UCSD-Quadcopter-Class/quad-hardware-yq_10/quadcopter.brd

## EAGLE design quadcopter.brd (2017-05-15)

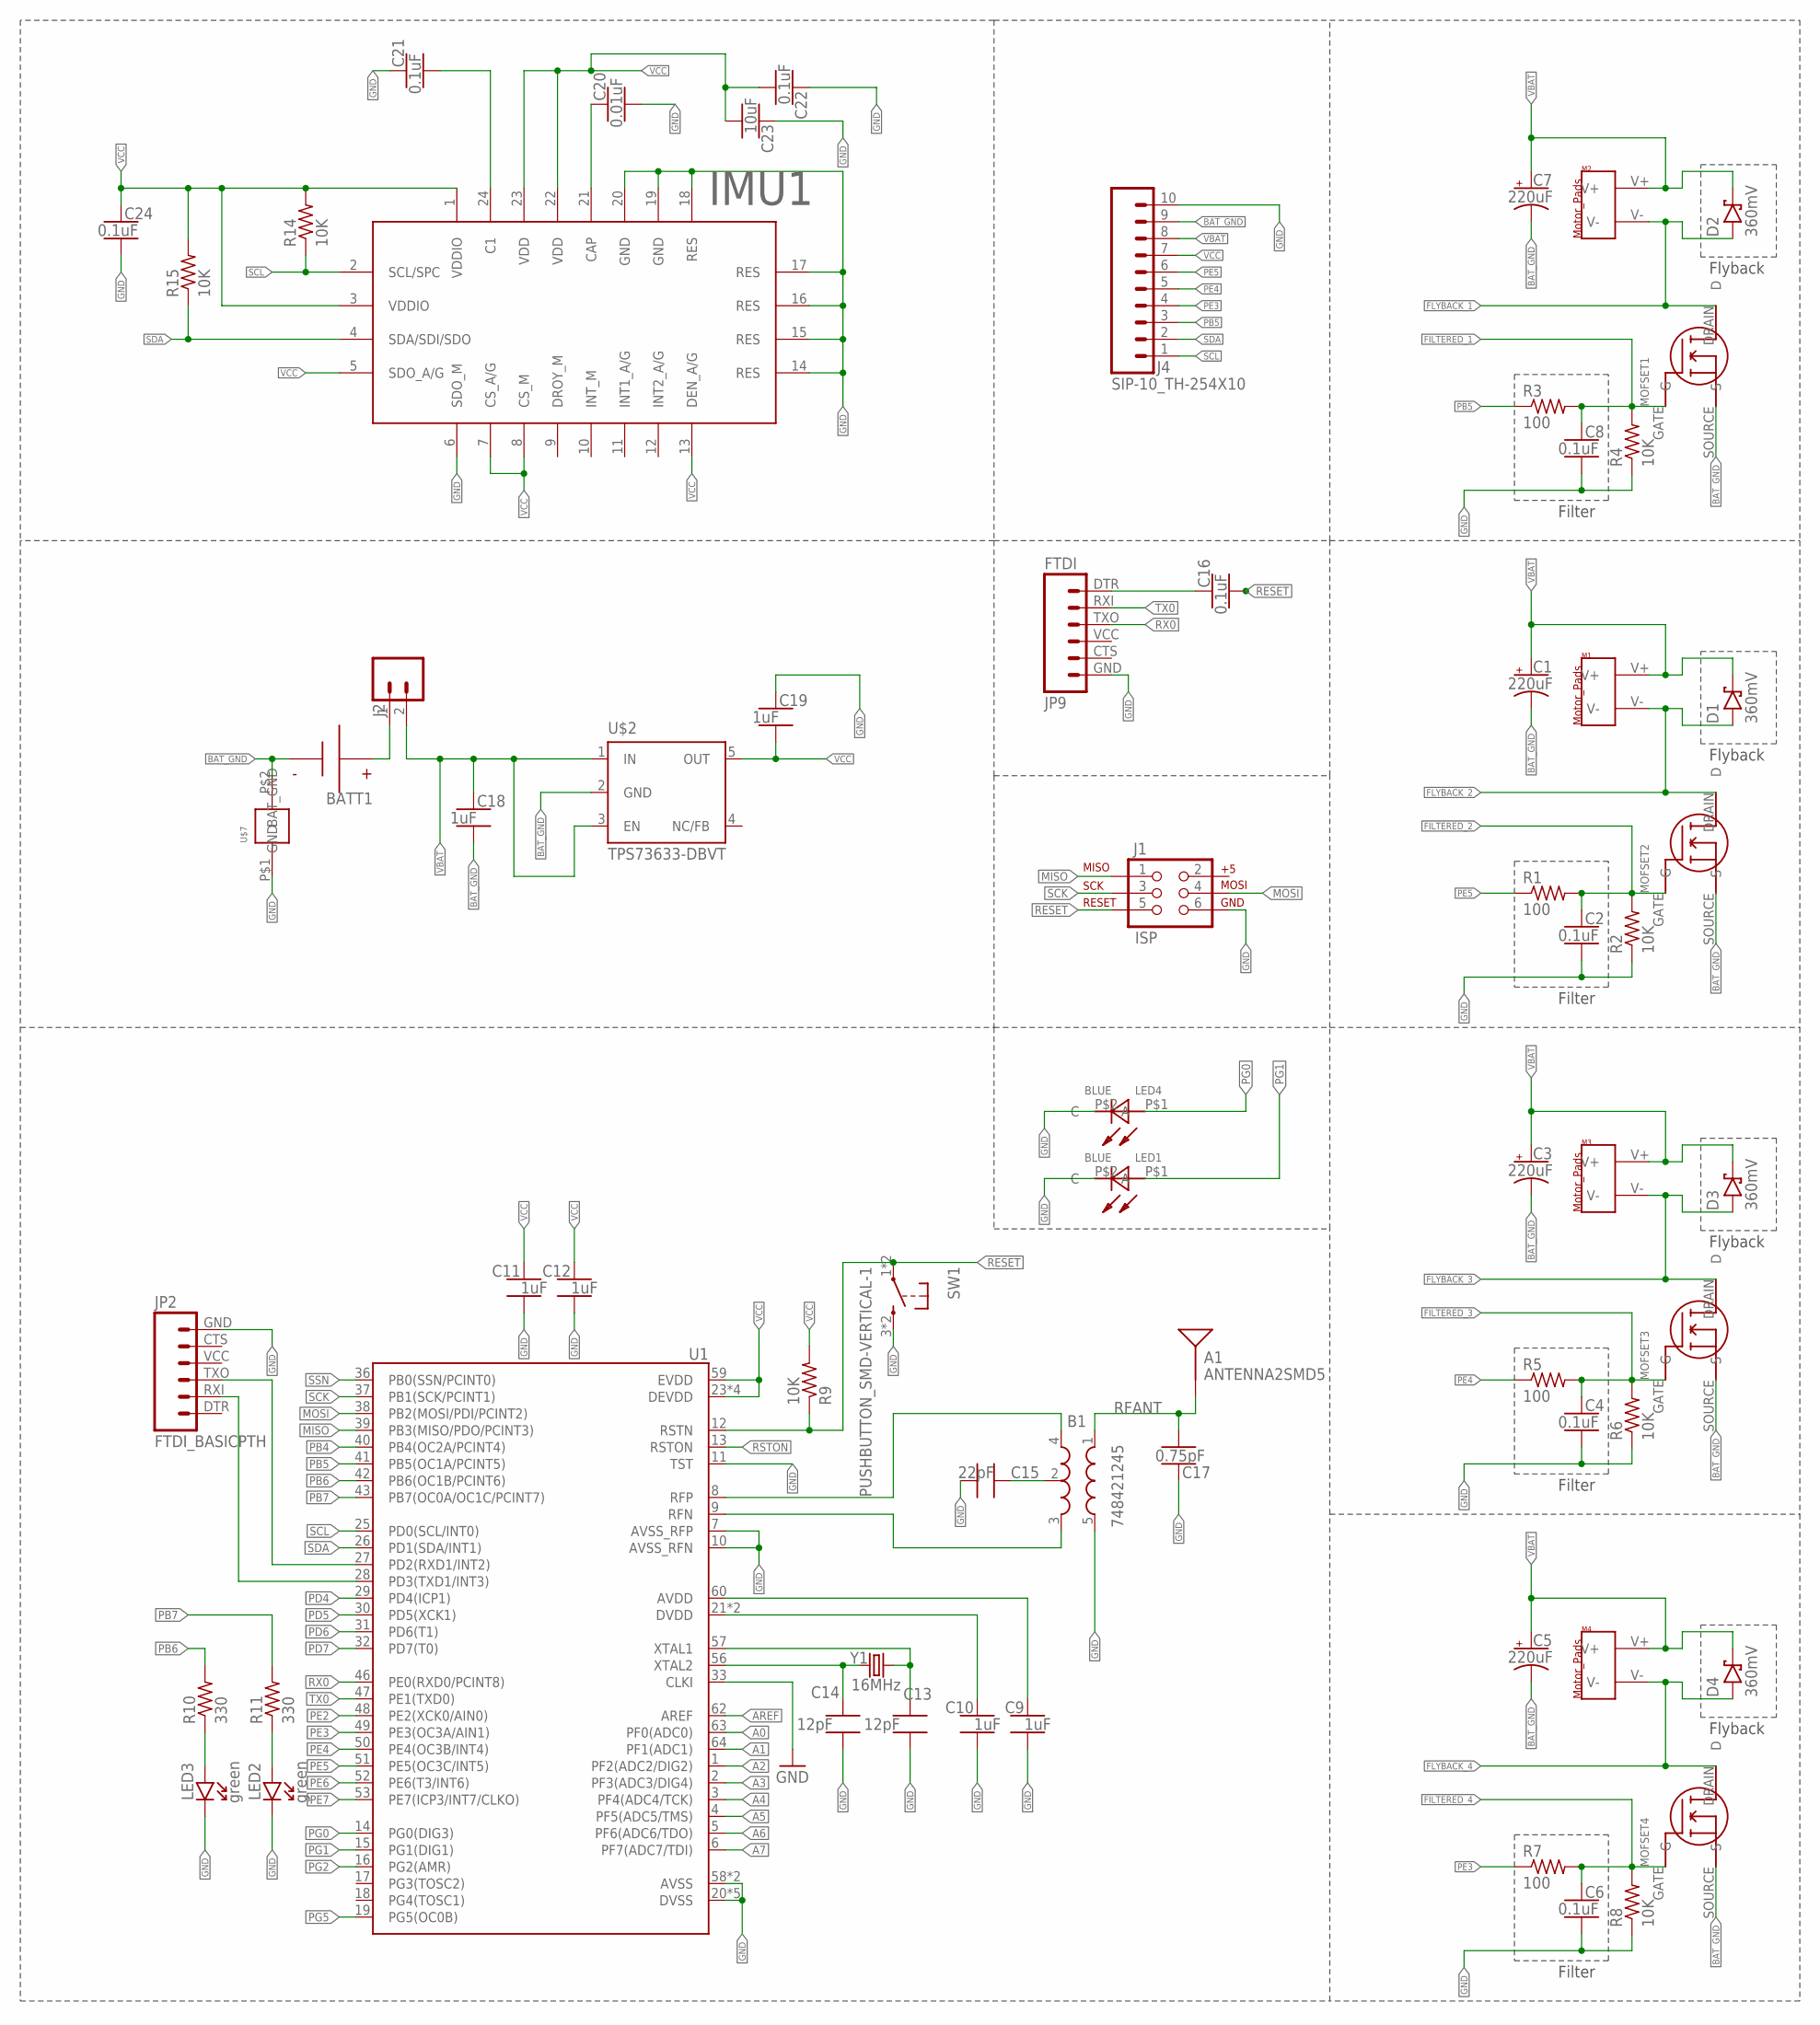
[picture p1: schematic quadcopter.sch]

Parts:
A1: ANTENNA2SMD5; ANTENNA-CHIP5
B1: 748421245; BALUN
BATT1: BATTERY-HUBSAN-W/HOLDER; BATTERY-W/HOLDER-380MAH-HUBSAN
C1, C3, C5, C7: 220uF; CAPMP7343X310_HS
C2, C4, C6, C8, C16, C21, C22, C24: 0.1uF; CAPC2012X140_HS
C9, C10, C11, C12, C18, C19: 1uF; CAPC2012X140_HS
C13, C14: 12pF; CAPC2012X140_HS
C15: 22pF; CAPC2012X140_HS
C17: 0.75pF; CAPC2012X140_HS
C20: 0.01uF; CAPC2012X140_HS
C23: 10uF; CAPC2012X140_HS
D1, D2, D3, D4: 360mV; SOD3716X135_HS
IMU1: 9_AXIS_IMU
J1: ISP; 2X3-NS
J2: MALE_HEADER_2POS-2X1-0.1IN; MALE_HEADER_2X1_0.1IN
J4: SIP-10_TH-254X10; HDRV10W63P254_10X1_2540X254H838_HS
JP2: FTDI_BASICPTH; FTDI_BASIC
JP9: FTDI; FTDI_BASIC
LED1, LED4: BLUE; CUT_TAPE
LED2, LED3: green; LEDSC125X200X120-2_HS
M1, M2, M3, M4: MOTOR_PADS
MOFSET1, MOFSET2, MOFSET3, MOFSET4: SI2302CDS_N_MOFSETSI2302CDS; N-CHANNEL_MOSFET
R1, R3, R5, R7: 100; RESC2012X60_HS
R2, R4, R6, R8, R9, R14, R15: 10K; RESC2012X60_HS
R10, R11: 330; RESC2012X60_HS
SW1: PUSHBUTTON_SMD-VERTICAL-1; TE_FSM8JSMA_HS
U1: ATMEGA128RFA1; QFN-64
U$2: TPS73633-DBVT; SOT23-DBV
U$7: NET_BRIDGE
Y1: 16MHz; CRYSTAL-SMD-5X3

Connections:
A0: U1.63 (PF0(ADC0))
A1: U1.64 (PF1(ADC1))
A2: U1.1 (PF2(ADC2/DIG2))
A3: U1.2 (PF3(ADC3/DIG4))
A4: U1.3 (PF4(ADC4/TCK))
A5: U1.4 (PF5(ADC5/TMS))
A6: U1.5 (PF6(ADC6/TDO))
A7: U1.6 (PF7(ADC7/TDI))
AREF: U1.62 (AREF)
AVDD: C9.1, U1.60 (AVDD)
BAT_GND: BATT1.- (N), C1.2 (-), C3.2 (-), C5.2 (-), C7.2 (-), C18.2, J4.9, MOFSET1.SOURCE (S), MOFSET2.SOURCE (S), MOFSET3.SOURCE (S), MOFSET4.SOURCE (S), U$2.2 (GND), U$7.P$2 (GND)
DTR: C16.1, JP9.DTR (1)
DVDD: C10.1, U1.21 (DVDD), U1.22 (DVDD)
FILTERED_1: C8.1, MOFSET1.GATE (G), R3.2, R4.2
FILTERED_2: C2.1, MOFSET2.GATE (G), R1.2, R2.2
FILTERED_3: C4.1, MOFSET3.GATE (G), R5.2, R6.2
FILTERED_4: C6.1, MOFSET4.GATE (G), R7.2, R8.2
FLYBACK_1: D2.A, M2.V-, MOFSET1.DRAIN (D)
FLYBACK_2: D1.A, M1.V-, MOFSET2.DRAIN (D)
FLYBACK_3: D3.A, M3.V-, MOFSET3.DRAIN (D)
FLYBACK_4: D4.A, M4.V-, MOFSET4.DRAIN (D)
GND: B1.5 (GND), C2.2, C4.2, C6.2, C8.2, C9.2, C10.2, C11.2, C12.2, C13.2, C14.2, C15.2, C17.1, C19.1, C20.2, C21.1, C22.1, C23.1, C24.2, IMU1.6 (SDO_M), IMU1.14 (RES), IMU1.15 (RES), IMU1.16 (RES), IMU1.17 (RES), IMU1.18 (RES), IMU1.19 (GND), IMU1.20 (GND), J1.6, J4.10, JP2.GND (6), JP9.GND (6), LED1.P$2 (C), LED2.C, LED3.C, LED4.P$2 (C), R2.1, R4.1, R6.1, R8.1, SW1.3 (2), SW1.4 (2), U1.7 (AVSS_RFP), U1.10 (AVSS_RFN), U1.11 (TST), U1.20 (DVSS), U1.24 (DVSS), U1.33 (CLKI), U1.35 (DVSS), U1.45 (DVSS), U1.55 (DVSS), U1.58 (AVSS), U1.61 (AVSS), U$7.P$1 (BAT_GND)
MISO: J1.1, U1.39 (PB3(MISO/PDO/PCINT3))
MOSI: J1.4, U1.38 (PB2(MOSI/PDI/PCINT2))
unnamed: C20.1, IMU1.21 (CAP)
unnamed: C21.2, IMU1.24 (C1)
unnamed: JP2.RXI (2), U1.28 (PD3(TXD1/INT3))
unnamed: JP2.TXO (3), U1.27 (PD2(RXD1/INT2))
unnamed: BATT1.+, J2.1
unnamed: C13.1, U1.57 (XTAL1), Y1.3 (2)
unnamed: C14.1, U1.56 (XTAL2), Y1.1
unnamed: B1.2 (GND), C15.1
unnamed: LED3.A, R10.1
unnamed: LED2.A, R11.1
unnamed: B1.4 (OUT1), U1.8 (RFP)
unnamed: B1.3 (OUT2), U1.9 (RFN)
PB4: U1.40 (PB4(OC2A/PCINT4))
PB5: J4.3, R3.1, U1.41 (PB5(OC1A/PCINT5))
PB6: R10.2, U1.42 (PB6(OC1B/PCINT6))
PB7: R11.2, U1.43 (PB7(OC0A/OC1C/PCINT7))
PD4: U1.29 (PD4(ICP1))
PD5: U1.30 (PD5(XCK1))
PD6: U1.31 (PD6(T1))
PD7: U1.32 (PD7(T0))
PE2: U1.48 (PE2(XCK0/AIN0))
PE3: J4.4, R7.1, U1.49 (PE3(OC3A/AIN1))
PE4: J4.5, R5.1, U1.50 (PE4(OC3B/INT4))
PE5: J4.6, R1.1, U1.51 (PE5(OC3C/INT5))
PE6: U1.52 (PE6(T3/INT6))
PE7: U1.53 (PE7(ICP3/INT7/CLKO))
PG0: LED4.P$1 (A), U1.14 (PG0(DIG3))
PG1: LED1.P$1 (A), U1.15 (PG1(DIG1))
PG2: U1.16 (PG2(AMR))
PG5: U1.19 (PG5(OC0B))
RESET: C16.2, J1.5, R9.1, SW1.1, SW1.2 (1), U1.12 (RSTN)
RFANT: A1.FEED, B1.1 (IN), C17.2
RSTON: U1.13 (RSTON)
RX0: JP9.TXO (3), U1.46 (PE0(RXD0/PCINT8))
SCK: J1.3, U1.37 (PB1(SCK/PCINT1))
SCL: IMU1.2 (SCL/SPC), J4.1, R14.1, U1.25 (PD0(SCL/INT0))
SDA: IMU1.4 (SDA/SDI/SDO), J4.2, R15.1, U1.26 (PD1(SDA/INT1))
SSN: U1.36 (PB0(SSN/PCINT0))
TX0: JP9.RXI (2), U1.47 (PE1(TXD0))
VBAT: C1.1 (+), C3.1 (+), C5.1 (+), C7.1 (+), C18.1, D1.C, D2.C, D3.C, D4.C, J2.2, J4.8, M1.V+, M2.V+, M3.V+, M4.V+, U$2.1 (IN), U$2.3 (EN)
VCC: C11.1, C12.1, C19.2, C22.2, C23.2, C24.1, IMU1.1 (VDDIO), IMU1.3 (VDDIO), IMU1.5 (SDO_A/G), IMU1.7 (CS_A/G), IMU1.8 (CS_M), IMU1.13 (DEN_A/G), IMU1.22 (VDD), IMU1.23 (VDD), J4.7, R9.2, R14.2, R15.2, U1.23 (DEVDD), U1.34 (DEVDD), U1.44 (DEVDD), U1.54 (DEVDD), U1.59 (EVDD), U$2.5 (OUT)

Notes on the sheet:
Filter
Flyback

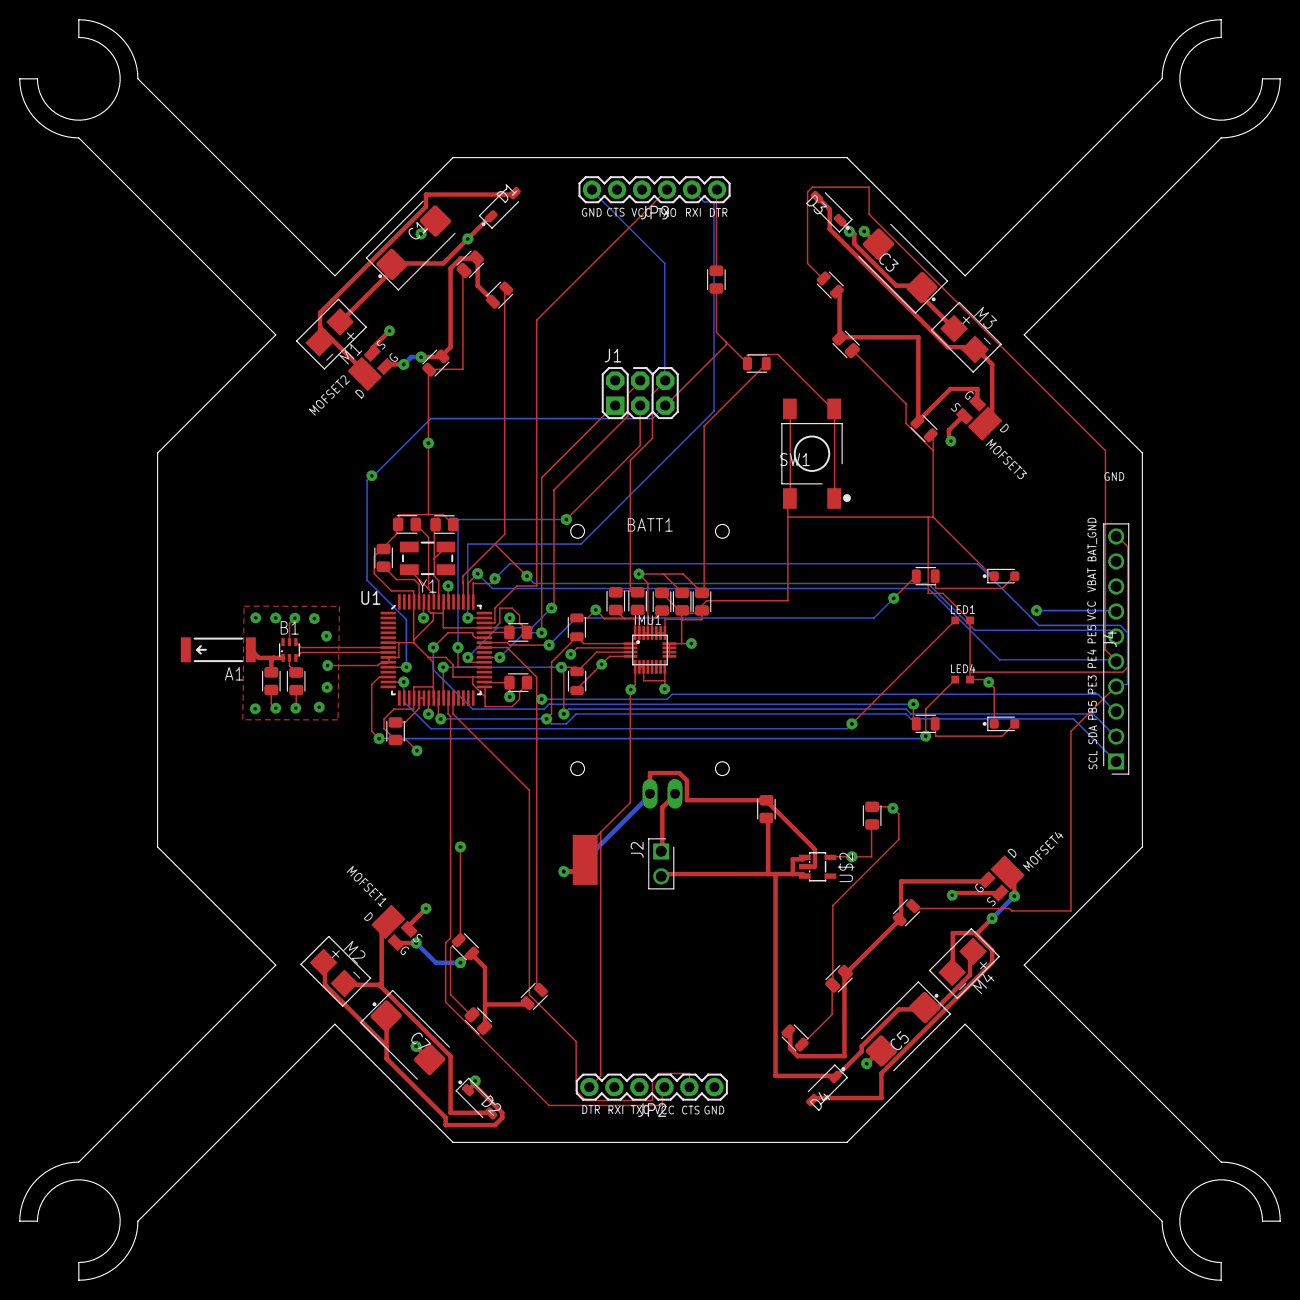
[picture p2: board quadcopter.brd from above]

Board: 4 copper layers, 128.0 x 128.0 mm, 67 parts (0 on the bottom side), 44 nets.
