UCSD-Quadcopter-Class/quad-hardware-yq_10/(commit log)

2017-04-19 LED discrete indication datasheet
    The LED datasheet referred to draw the smd LED library.
2017-04-19 Student built library and LED library
    LED library is built based on the datasheet uploaded into the datasheet folder.
2017-04-20 initial-schematic
    Lab 4 Part A
    [quadcopter.sch]
2017-04-20 Modification to these two libraries
    Added net bridge into the prebuilt one and added few new capacitors and resistors with different values
2017-04-20 led_notes.txt
    Describe how the LED was selected and designed.
2017-04-25 Question about schematic design by Group 9
2017-04-25 Schematic edited on April 24th
    [quadcopter.sch]
2017-04-25 Edited IMU and MOSFET pad size
    [quadcopter.sch]
2017-04-27 instructior review of original schematic
2017-05-02 Modified schematic and initial board
    Schematic has been modified based on design review and board has been layout.
    [quadcopter.brd, quadcopter.sch]
2017-05-04 Board review by Group 9
2017-05-08 Version before generating cam
    [quadcopter.brd, quadcopter.sch]
2017-05-09 Version May 8th 11pm
    Version before rerun the autorouter with new dru
    [quadcopter.brd, quadcopter.sch]
2017-05-09 Board and Schematic that pass DFM
    [quadcopter.brd]
2017-05-09 Board passed DFM
2017-05-09 Schematic passed DFM
2017-05-10 Board design review 1
2017-05-11 New board passed DFM using new DRU and CAM
2017-05-11 New board passed DFM with new DRU and CAM
    [quadcopter.brd]
2017-05-11 new schematic passed DFM
2017-05-11 new schematic May 10th
2017-05-11 New board after Prof. review on May 10th
    [quadcopter.brd]
2017-05-11 New schematic after Prof. review on May 10th
    [quadcopter.sch]
2017-05-11 Modified the pad size of MOSFET
2017-05-11 new board after Prof.'s review on May 10th
    [quadcopter.brd]
2017-05-11 new schematic after Prof.'s review on May 10th
2017-05-11 New board with de cap connecting to microcon
    [quadcopter.brd]
2017-05-11 New schematic after modifying decoup cap
    [quadcopter.sch]
2017-05-12 New cam files modified decoupling cap for imu
2017-05-12 new board modified decoupling cap for imu
    [quadcopter.brd]
2017-05-12 cam layer files modified decoupling cap for imu
2017-05-14 more schematic comments from swanson
2017-05-14 New cam file fixed decoupling caps in motor driver
2017-05-14 New schematic fixed decoupling caps
    [quadcopter.sch]
2017-05-14 New board fixed de cap and bat_gnd
    [quadcopter.brd]
2017-05-15 Replaced decoupling caps for motor drivers
    [quadcopter.sch]
